PWRJOY/paperflow/output/preview_back.png

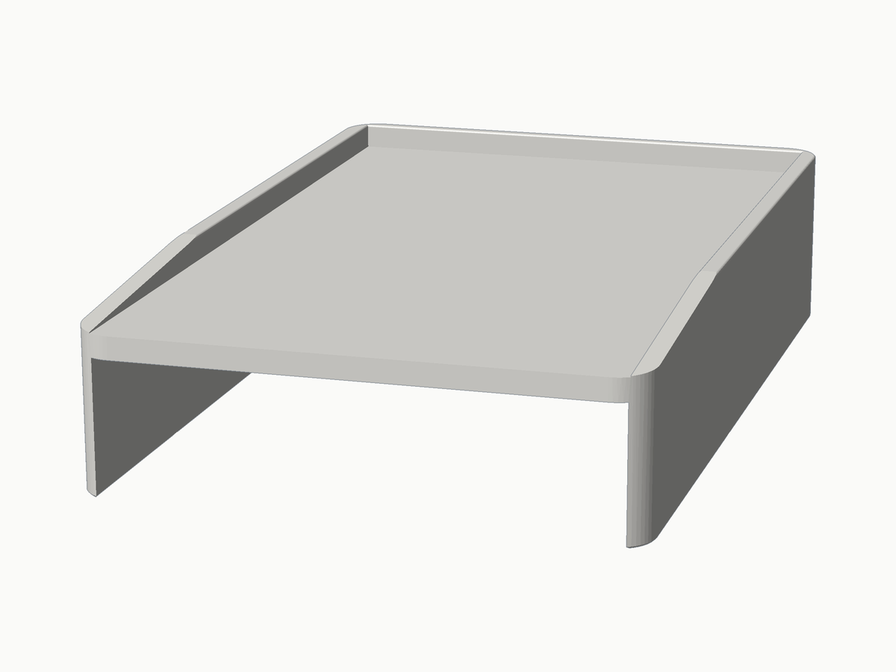
output/preview_back.png
