PWRJOY/paperflow/output/preview_bottom.png

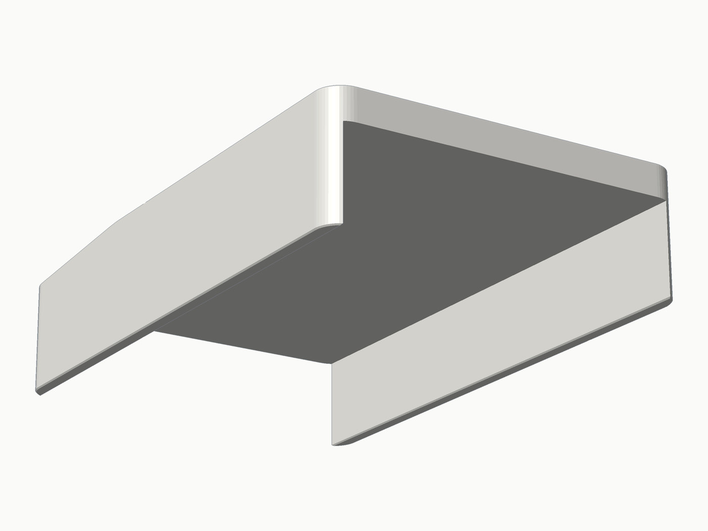
output/preview_bottom.png
