PWRJOY/paperflow/output/preview_front.png

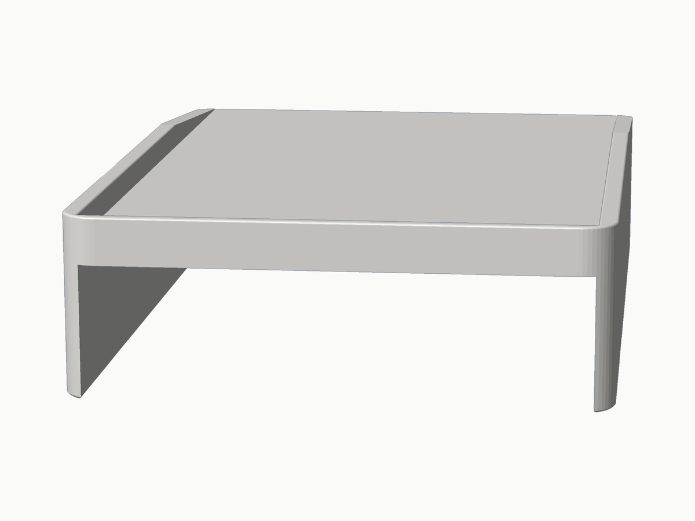
output/preview_front.png
