PWRJOY/paperflow/output/preview_sheet.png

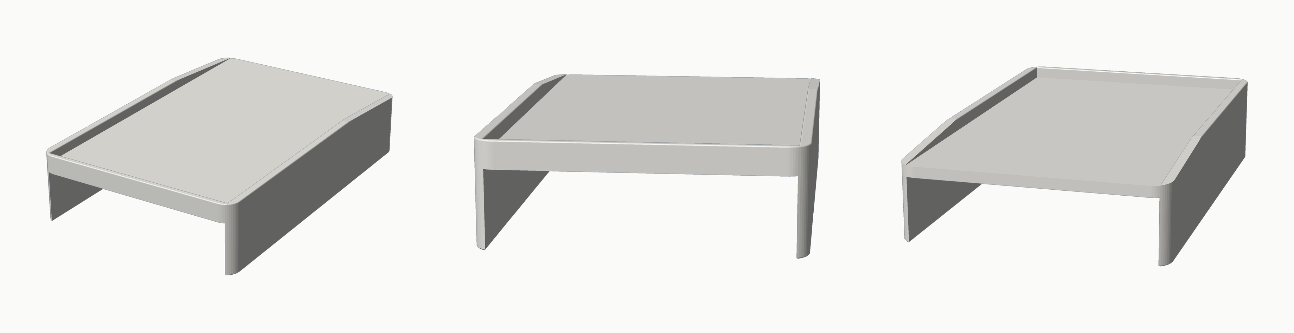
output/preview_sheet.png
