PWRJOY/paperflow/output/preview_top.png

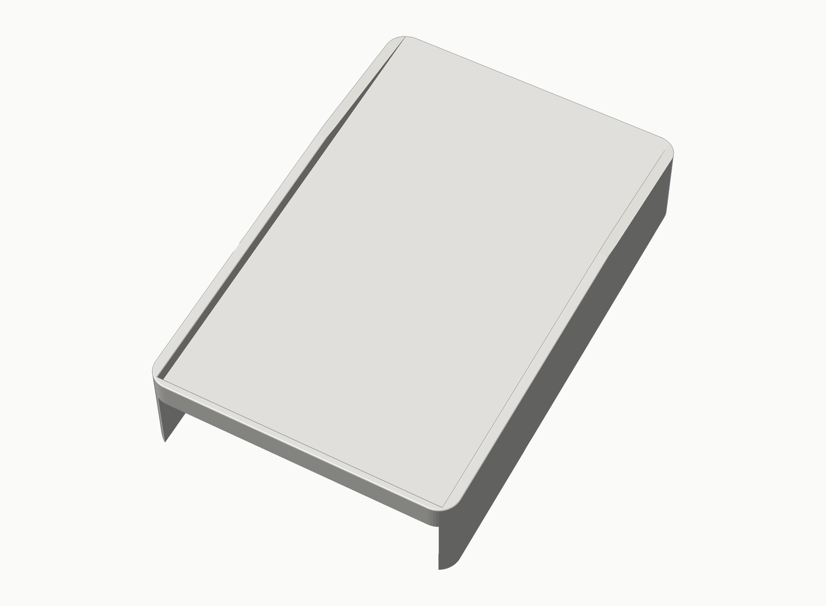
output/preview_top.png
