PWRJOY/paperflow/output/riser.step

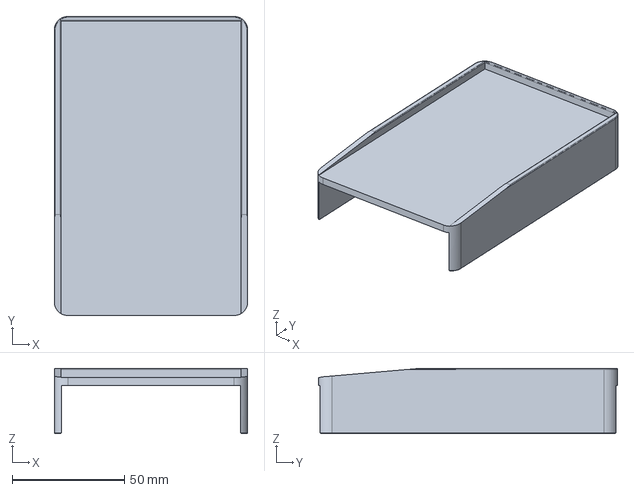
[picture p10: CAD file, 2026-11-04]
output/riser.step
86.0 x 133.0 x 29.0 mm
