PWRJOY/paperflow/(list of files, cad)

Other CAD files:
output/riser.stl
