PWRJOY/paperflow/(commit log)

2026-11-04 快递面单打印机理线增高架 v3
    台面 80x130mm、抬高 25mm 的一体打印托架，内部空腔收纳打印机电源线与 USB 线。
    - 结构：顶板 + 左右侧壁，前/后/下三面通透
    - 顶面三面 4mm 挡边，前 45mm 渐隐斜坡
    - 61.9 cm3，打印时必须侧立摆放，免支撑免桥接
    - 附带 build123d 参数化脚本与 STL 预览渲染器
    [riser.step, riser.stl]
2026-11-04 docs: 补充设计笔记
    记录三版迭代的取舍过程：v1 完整壳体 88.8 cm3 -> v2 拆底板隔板 63.5 -> v3 去掉卡扣 61.9。
    重点是打印方向的坑（正放需 79.6mm 桥接、倒扣被挡边顶起 4mm，都必须侧立才能免支撑），
    以及 build123d 的 chamfer 失败、Python 版本、State() 枚举判断几个实际问题。
    README 增加两处入口链接。
2026-11-08 docs: 修正 README 两处描述错误
    - 原文"电源线和 USB 线会把桌面顶起来"不通，改为线压在桌面上、面单铺上去被拱起来
    - 挡边的作用写反了：不是防止面单往后滑落，而是顶住打印机送纸时的拉力，
    面单连在机内纸卷上，送纸时整张纸都在往打印机方向被拽
    - 同步修正 design-notes.md 里的同样表述，以及"从打印机那侧推上面单"
    与挡边位置相矛盾的说法
    - codes/riser.py 文档字符串仍写着"正放打印无需支撑"，与侧立结论相反，一并改正
2026-11-08 docs: 加入改造前/后的实拍图
    - docs/images/before-label-lifted.jpg：面单压在盘好的线缆上，中间架空
    - docs/images/before-cables.jpg：电源线和 USB 线只能盘在打印机后方那一小片桌面
    - docs/images/riser-in-use.jpg：打印出来的实物，面单平放在台面上
    - 原图 4K 压到 1400px / quality 85，三张共 546 KB
    - 高清原图与视频归档到 docs/_raw/，已加入 .gitignore，不入库
    - README 增加「改造前」「改造后」两节，渲染图移到「结构」一节下
2026-11-08 docs: 加入打印过程的实拍视频
    - docs/media/riser-demo.mp4：H.264 重编码（原片是 HEVC，部分浏览器放不出来），
    去掉音轨，2.4s / 720x1280，371 KB
    - docs/media/riser-demo.gif：从视频转的循环动图，裁掉上下无关区域，
    10fps、112 色，1.6 MB，README 里直接播放，点击跳原视频
    - README「改造后」一节补上这段，说明纸从机器出来时带着卷曲
2026-11-08 docs: 修正实拍图对应的改造前/后
    之前把两张照片的身份搞反了：
    - 手举着一摞面单、桌上盘着线缆的那张才是改造前（问题现场）
    - 面单平放在白色架子上的那张是改造后（架子在用）
    调整：
    - 改造前只用 before-cables.jpg 一张，限制宽度 440px（竖构图），配文补上"只能一只手举着"
    - 改造后改用 after-labels-on-riser.jpg（由 before-label-lifted.jpg 改名，文件名不再误导）
    - 删除 riser-in-use.jpg（内容与改造后重复，用户确认不需要）
